eengnr/wmat/images/wmat_p1.jpg

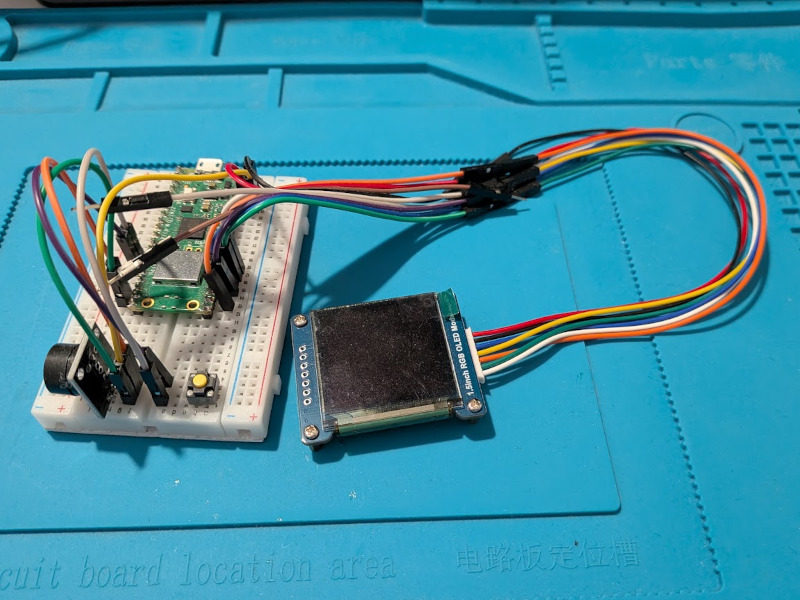
images/wmat_p1.jpg
