eengnr/wmat/images/wmat_p2.jpg

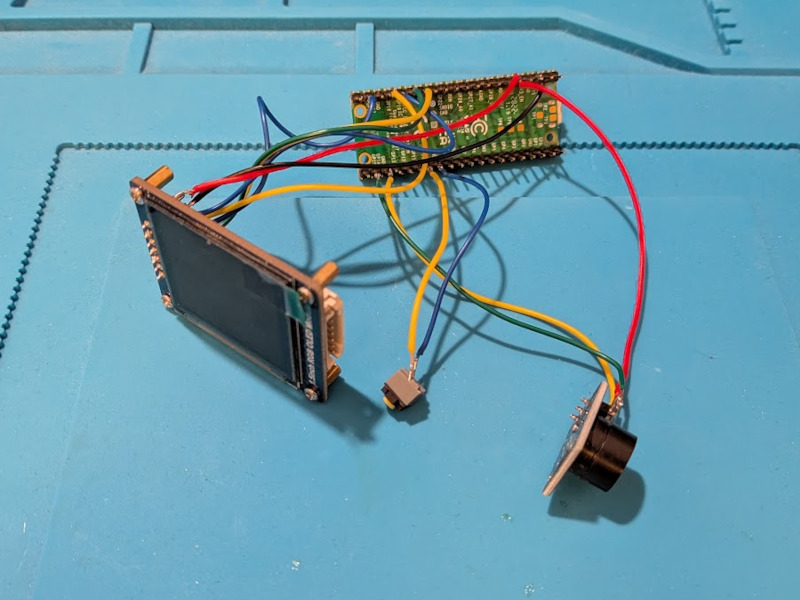
images/wmat_p2.jpg
