eengnr/wmat/images/wmat_p3.jpg

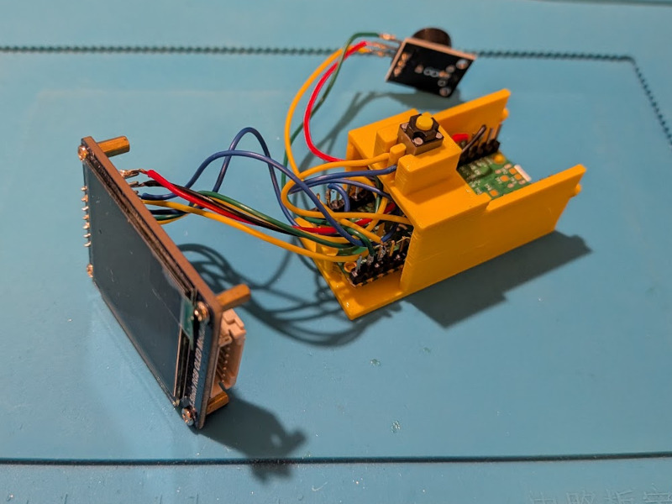
images/wmat_p3.jpg
