eengnr/wmat/enclosure/enclosure_chassis.stl

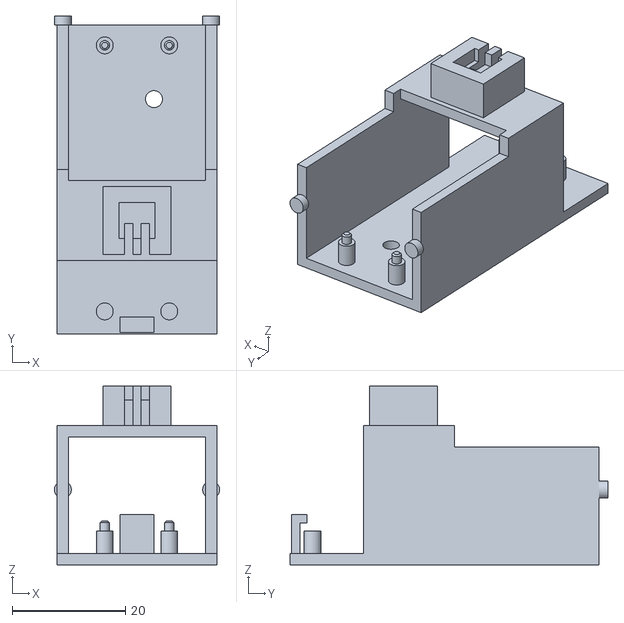
[picture p5: CAD file, 2026-11-08]
enclosure/enclosure_chassis.stl
29.2 x 56.2 x 31.6
