eengnr/wmat/enclosure/enclosure_button.stl

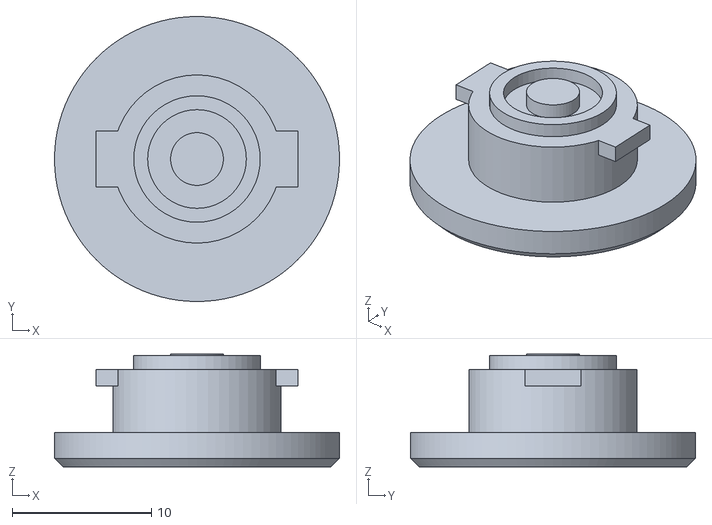
[picture p6: CAD file, 2026-11-08]
enclosure/enclosure_button.stl
20.5 x 20.5 x 8.10
