eengnr/wmat/enclosure/enclosure_housing.stl

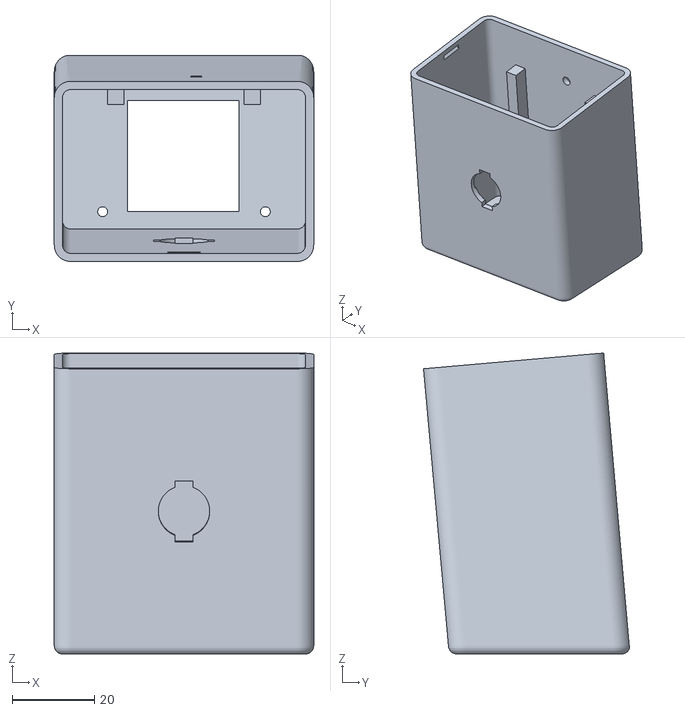
[picture p7: CAD file, 2026-11-08]
enclosure/enclosure_housing.stl
63.0 x 50.0 x 73.1
