eengnr/wmat/enclosure/enclosure_lid.stl

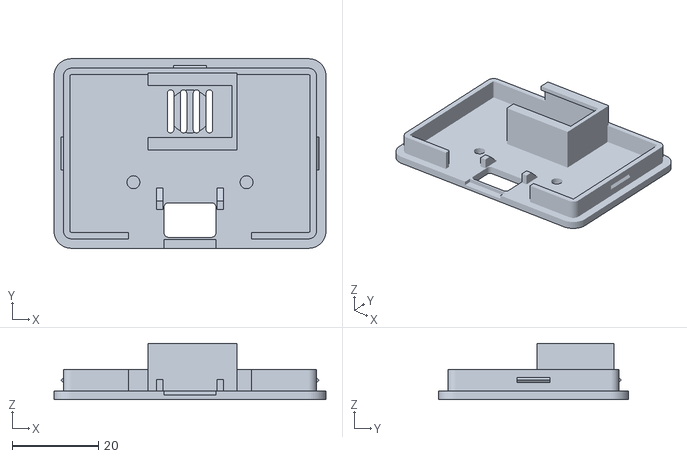
[picture p8: CAD file, 2026-11-08]
enclosure/enclosure_lid.stl
63.0 x 43.9 x 13.0
