eengnr/wmat/src/melodies.py

MELODIES = {
    "Default": [
        ("tone", 1800, 4000, 150),
        ("pause", None, None, 150),
        ("tone", 1800, 4000, 150),
        ("pause", None, None, 150),
        ("tone", 1800, 4000, 150),
        ("pause", None, None, 500),
    ],
    "HappyWake": "HappyWake:d=8,o=5,b=80:e,g,a,g,e,d,e,g,a,c6",
    "CalmRise": "CalmRise:d=4,o=5,b=55:d,f#,a,f#,d,e,g,e,d,a,b,a,g,e,d,f#,a,d6,a,f#,e,g,e,d,f#,a,g,e,d",
    # More examples at https://lhlab.wiki/wiki/RTTTL_Songs
}
