eengnr/wmat/src/mqtt_topics.py

MQTT_TOPICS = {
    "debug_in": "/test/in",
    "debug_out": "/test/out",
    "available": "/available",
    "alarms": "/alarms",
    "alarm_add": "/alarm/add",
    "alarm_remove": "/alarm/remove",
    "event": "/event",
    "state": "/state",
    "control": "/control",
    "weather": "/weather",
}
